gabrieldelgadoo/CV19_TETUAN/README.md

TODO LA INFO SE ENCUENTRA AQUI:

[https://cv19-tetuan.readthedocs.io/en/latest/#cv19_tetuan](https://cv19-tetuan.readthedocs.io/en/latest/#cv19_tetuan)

TODO LOS FICHEROS EN "ARCHIVOS STL"
