gabrieldelgadoo/CV19_TETUAN/docs/configs.md

## Configuraciones para Impresoras

### Prusa MKS3

Comprobado con Modelo A, GM

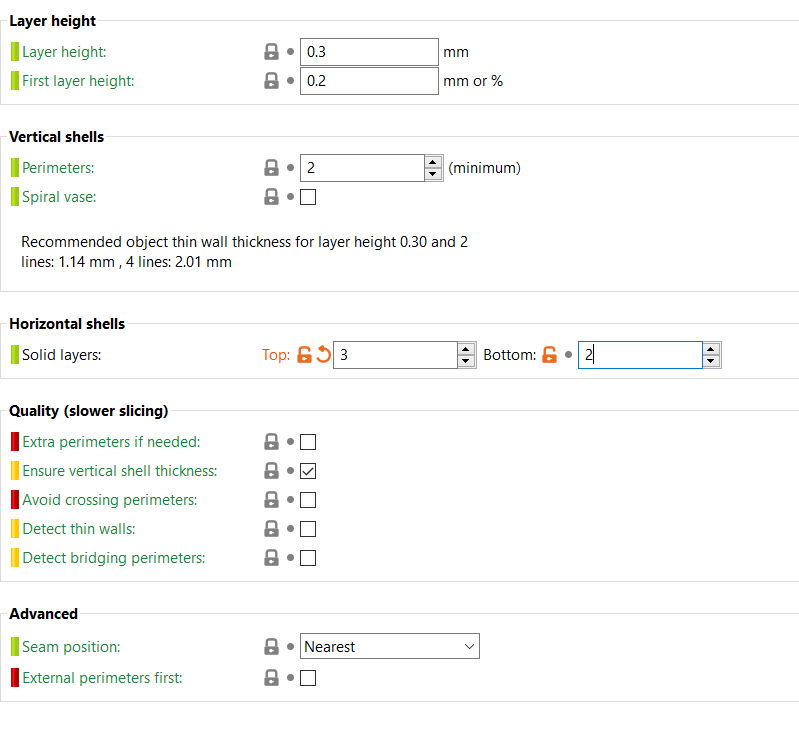
[picture p28: docs/configs/Prusa_MKS3/1.png]

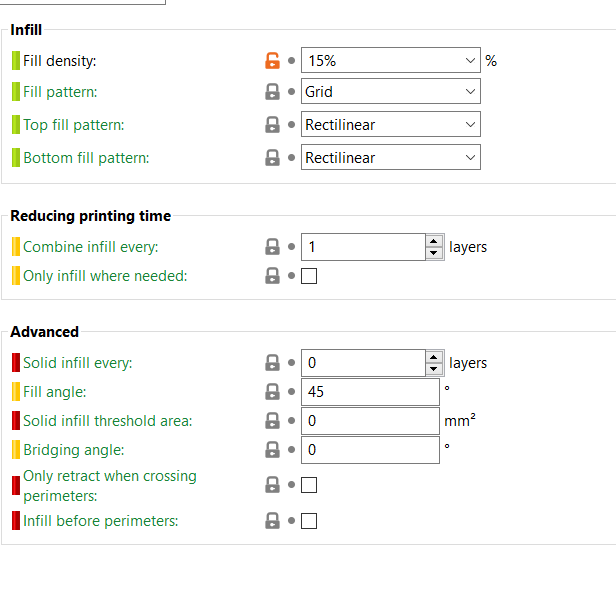
[picture p29: docs/configs/Prusa_MKS3/2.png]

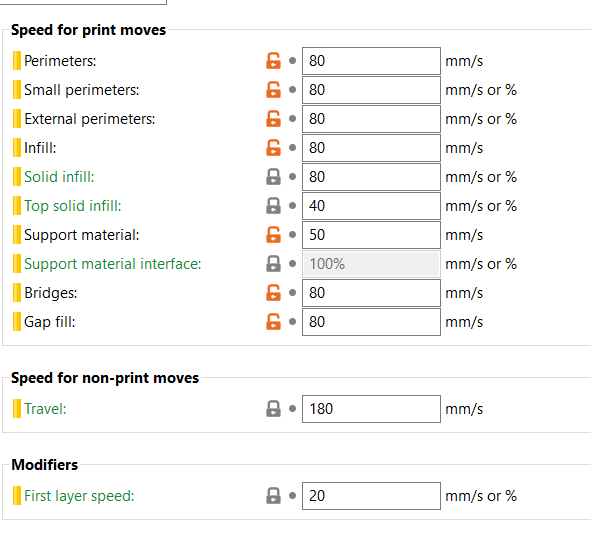
[picture p30: docs/configs/Prusa_MKS3/3.png]


### Ender 3

Comprobado con Modelo A

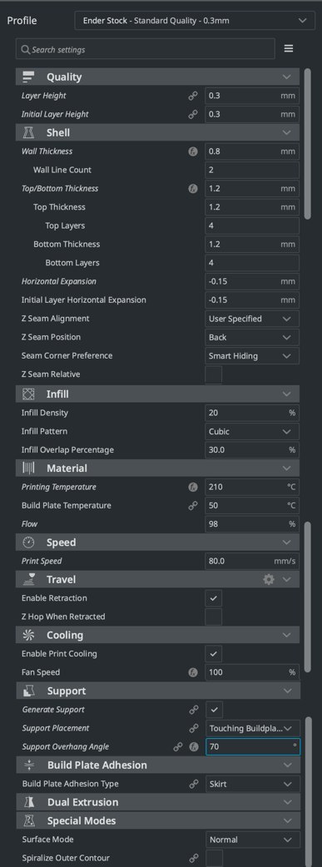
[picture p31: docs/configs/Ender3/1_Modelo_A.jpg]


[Cura Profile](configs/Ender3/Ender_Stock.curaprofile)

### Quiero anadir algo

Puedes hacer un Pull Request aqui: [https://github.com/gabrieldelgadoo/CV19_TETUAN](https://github.com/gabrieldelgadoo/CV19_TETUAN)

O escribir a mordondro[]gmail.com o @mordondro en telegram
