gabrieldelgadoo/CV19_TETUAN/docs/entrega.md

<p style="font-size: 2em;font-weight: bold;">
FAQ TETUAN</p>

## FAQ TETUAN

### Hay Version Homologada/acceptada?

Como sabéis hoy nos han comunicado que la visera ya no está validada por Sanidad de la Comunidad de Madrid, eso no quiere decir que no sirva.
Los Admins estan en ello de “Re-Validar” el diseno y esperamos que pronto sabemos mas.

### Donde conseguir PVC y Goma?

Tenemos en Tetuan mucho PVC gracias a el Grupo Social de la ONCE.
Para Pedidos dentro del Grupo no se "conseguir" comprar PVC, porque entregamos las Viseras sin montar.
Si quieres usar PVC para Viseras, que das tu a otra gente puedes preguntar en el Chat para poder circularlo hasta ti(por ejemplo con los Mensajeros)

### El grupo TG-Tetuan, para quien es?
En este grupo nos encontramos todos los Makers con Impresoras 3D para hacer Viseras!
O Gente que tiene el siguiente material y puede ayudar: Goma, Pantallas

Cualquier otra cosa teneis los otros canales de COVID, y si no encontráis ayudamos! 

### STOCK TETUAN

Encantando! Por Favor sigue estos 3 Pasos!

#### Como entrar en el Stock de Tetuan

1-Stock de Madrid por Barrio POR PERSONA: https://docs.google.com/forms/d/e/1FAIpQLSfA18D42zJwqL4fc2RPUaCodoov1gC751ZN3rm54v0EyADycg/viewform

Si ya habéis dado vuestros Impresiones a alguien, 091, bomberos, sanitarios, etc. Por Favor contabilizadlo aquí!

Por ejemplo:  Si tenías 15 viseras en stock pero las has entregado...Modificas el formulario de “Stock por Persona” para volver a tener 0.

#### Como cambio mi Stock?

- Entrar en tu Correo electrónico
- Buscar el mail de Google Forms
- Click “editar respuesta”
- Borrar tu Stock personal
- Enviar

No haceis una nueva submission del Formulario! Os ha llegado un mensaje al correo electronice de Googel Forms, donde hay un enlace para editar la respuesta!
A usar este!

### Que Modelo a imprimir?

MODELO ACEPTADO POR SANIDAD EN MADRID: https://covidmadrid.com/modelos-a-imprimir/
Existe también el Modelo del Gregorio Marañón pre-aprobado

### He impreso….que hago ahora?

Cuando tengáis el material listo y desinfectado (trapo con agua y un poquito de lejia)  ya sea montado, no montado, viseras homologadas, no homologadas, con PVCs, sin el, con goma, sin ella, da igual! Como si tenéis solo PVCs y gomas! Todo aporta! 
Si tienes un stock suficiente grande (10-15 Viseras) , por favor , en ese momento, COMUNICADLO a  @mordondro  y actualizad el Stock.

### Como entregar mis Viseras

1) Comprobar Calidad y dividir entre "para uso Sanitario", "NO para uso Sanitario"
 y "Basura"
2) Desinfectar las piezas con guantes y Lejilla/Alcool
3) Meterles en una bolsa limpia y desinfectada
4) Etiquetar la Bolsa con: ) Contenido ) para uso Sanitario o NO? )Nombre )RECIPIENTE

### Tenemos Punto de Recogida?

NO PODEMOS SALIR DE CASA PARA ENTREGAR COSAS! Si lo haces es por tu proprio asunto!
Tenemos contacto con el 091 y los Mensajeros y les recogen en casa de cada uno que tenga suficiente Stock! Cualquier pregunta: TG @mordondro

### Algun hospital me dice que necesitan!

Pedidos por nuestra Zona por favor a mi por Telegram o correo mordondro@gmail.com
(Sanitarios “privados”, Residencias de Ancianos, Supermercados, Tiendas, etc.)

### Quiero anadir algo

Puedes hacer un Pull Request aqui: [https://github.com/gabrieldelgadoo/CV19_TETUAN](https://github.com/gabrieldelgadoo/CV19_TETUAN)

O escribir a mordondro[]gmail.com o @mordondro en telegram
