gabrieldelgadoo/CV19_TETUAN/archivos STL/Madrid Modelo A/Modelo_A_V2_AdrianL_fijacion.stl

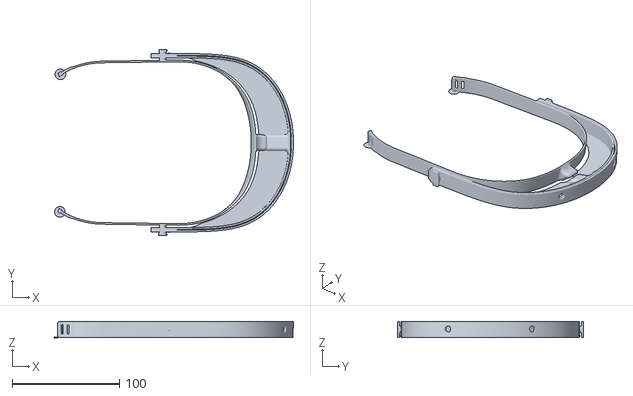
[picture p32: CAD file, 2020-04-06]
archivos STL/Madrid Modelo A/Modelo_A_V2_AdrianL_fijacion.stl
223.0 x 173.7 x 15.0
