gabrieldelgadoo/CV19_TETUAN/archivos STL/Madrid Modelo B/por partes/B2 Visera Madrid-Aprobada 1.0_fijacion.stl

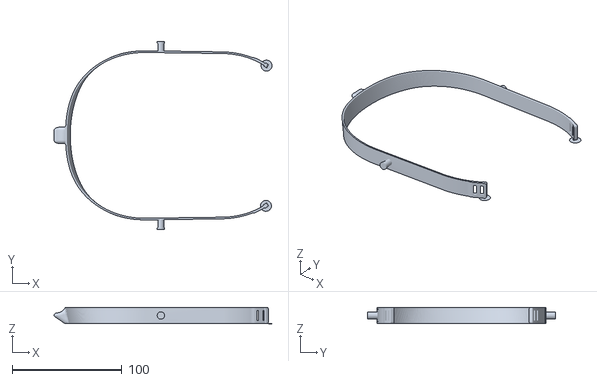
[picture p33: CAD file, 2020-04-17]
archivos STL/Madrid Modelo B/por partes/B2 Visera Madrid-Aprobada 1.0_fijacion.stl
198.7 x 171.2 x 15.0
