gabrieldelgadoo/CV19_TETUAN/archivos STL/Madrid Modelo B/Visera_B_junto_21x18_fijacion.stl

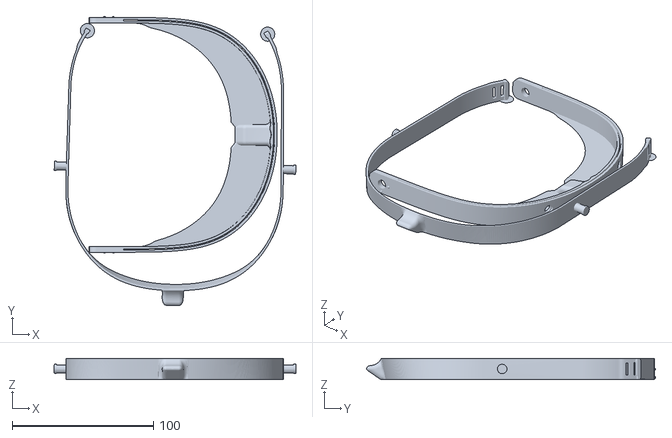
[picture p34: CAD file, 2020-04-22]
archivos STL/Madrid Modelo B/Visera_B_junto_21x18_fijacion.stl
171.2 x 204.8 x 15.0
