gabrieldelgadoo/CV19_TETUAN/archivos STL/Modelo A+B Accesorios/Adapter Modelo A 15mm.stl

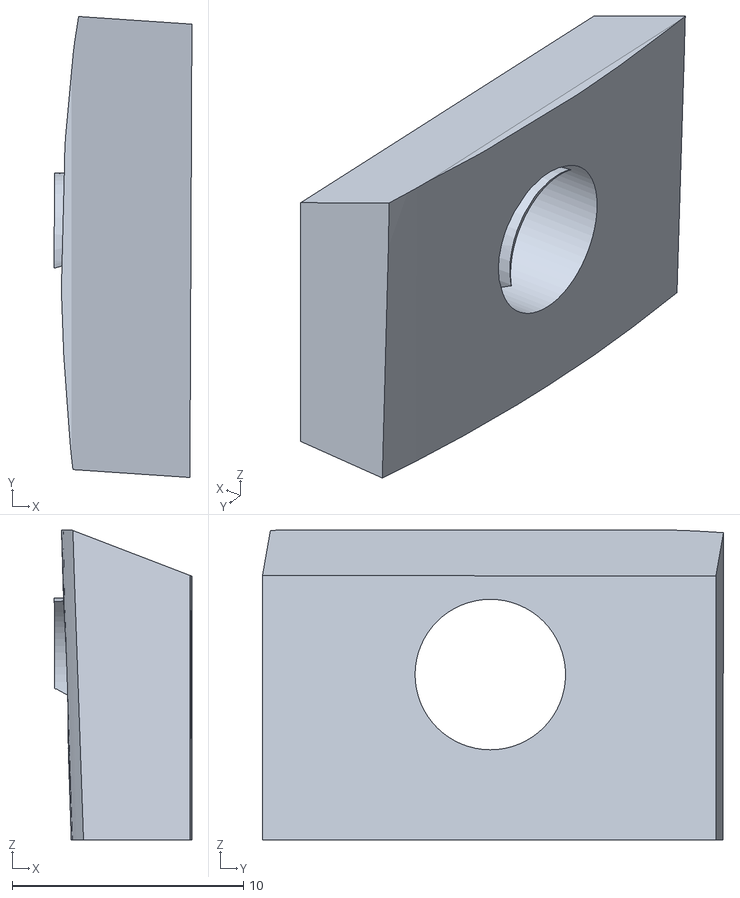
[picture p35: CAD file, 2020-04-04]
archivos STL/Modelo A+B Accesorios/Adapter Modelo A 15mm.stl
5.96 x 19.9 x 13.4
