gabrieldelgadoo/CV19_TETUAN/archivos STL/Modelos Gregorio Maranon/GM_v3_Tetuan.stl

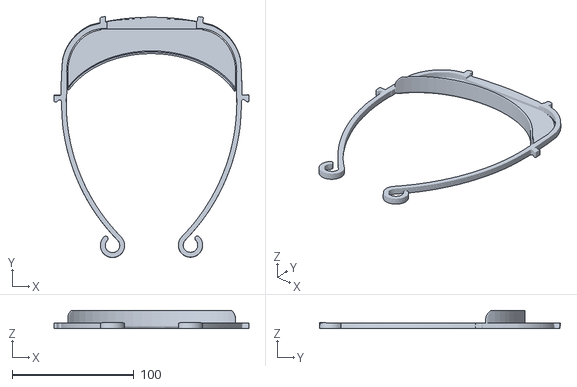
[picture p36: CAD file, 2020-04-17]
archivos STL/Modelos Gregorio Maranon/GM_v3_Tetuan.stl
159.9 x 197.8 x 15.0
