gabrieldelgadoo/CV19_TETUAN/archivos STL/visera_ultima_version(con ventilacion).stl

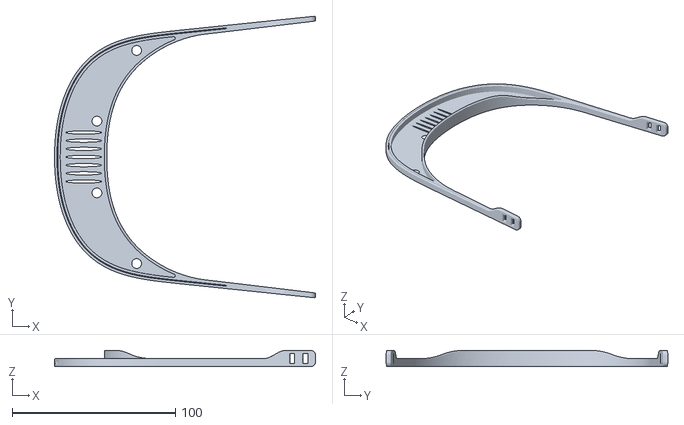
[picture p37: CAD file, 2020-04-04]
archivos STL/visera_ultima_version(con ventilacion).stl
159.8 x 172.4 x 10.0
