gabrieldelgadoo/CV19_TETUAN/archivos STL/Madrid Modelo B/Visera_B_junto_21x18.stl

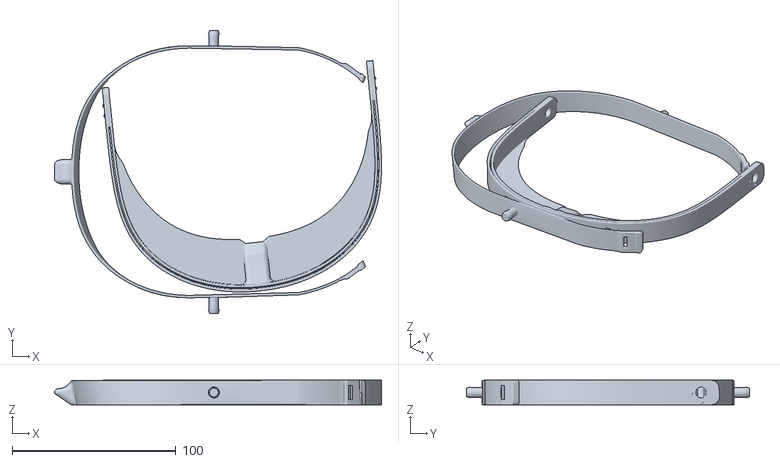
[picture p38: CAD file, 2020-04-04]
archivos STL/Madrid Modelo B/Visera_B_junto_21x18.stl
199.9 x 173.2 x 15.0
