gabrieldelgadoo/CV19_TETUAN/archivos STL/Modelo A+B Accesorios/punzonLH.stl

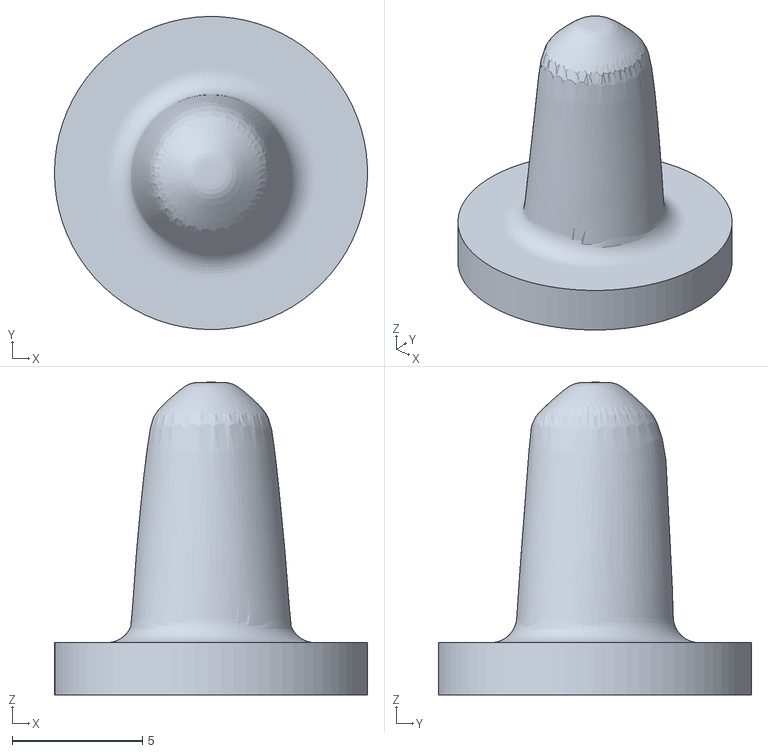
[picture p39: CAD file, 2020-04-04]
archivos STL/Modelo A+B Accesorios/punzonLH.stl
12.0 x 12.0 x 12.0
