gabrieldelgadoo/CV19_TETUAN/archivos STL/Modelos Gregorio Maranon/GM V3_Tetuan_2x_23x21.stl

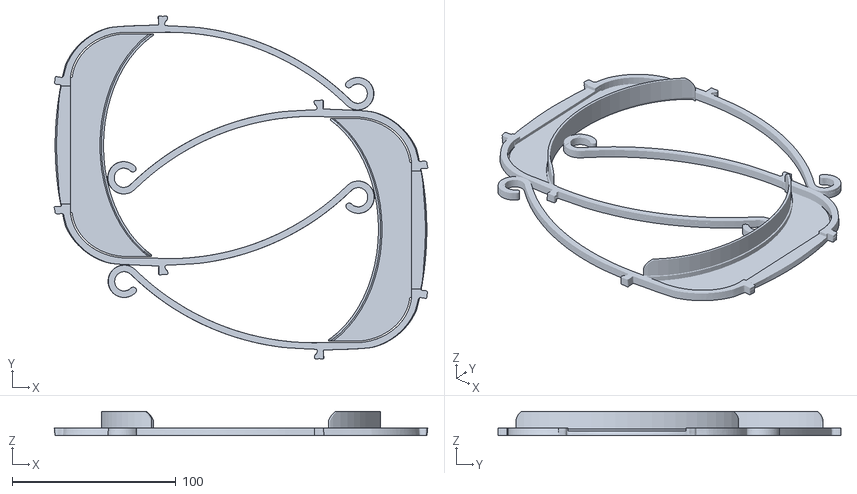
[picture p40: CAD file, 2020-04-07]
archivos STL/Modelos Gregorio Maranon/GM V3_Tetuan_2x_23x21.stl
228.6 x 209.8 x 14.8
