gabrieldelgadoo/CV19_TETUAN/archivos STL/Visor_Europeo_V21.stl

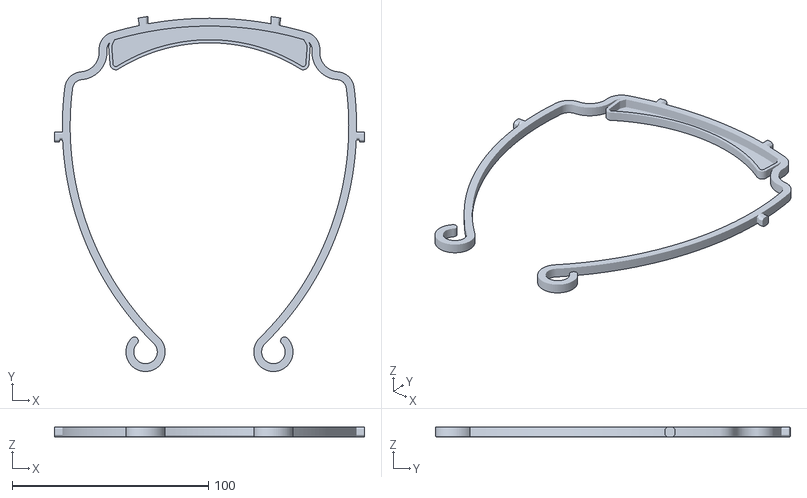
[picture p41: CAD file, 2020-04-04]
archivos STL/Visor_Europeo_V21.stl
158.0 x 181.0 x 5.00
