gabrieldelgadoo/CV19_TETUAN/archivos STL/Madrid Modelo B/Arandelas Visera Madrid-Aprobada 1.0.stl

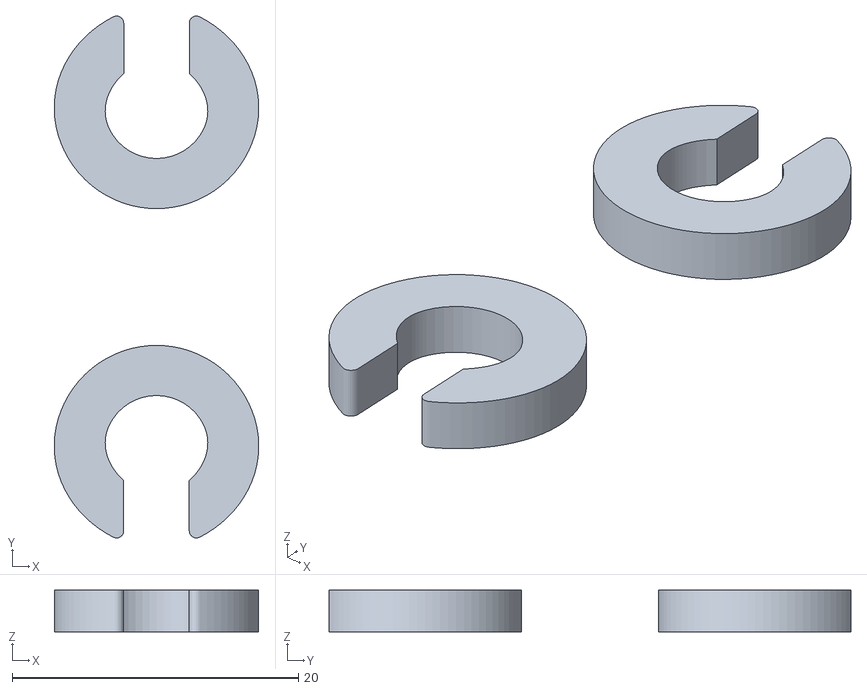
[picture p42: CAD file, 2020-04-04]
archivos STL/Madrid Modelo B/Arandelas Visera Madrid-Aprobada 1.0.stl
14.3 x 36.5 x 2.90
