gabrieldelgadoo/CV19_TETUAN/archivos STL/Madrid Modelo B/por partes/B1 Visera Madrid-Aprobada 1.0.stl

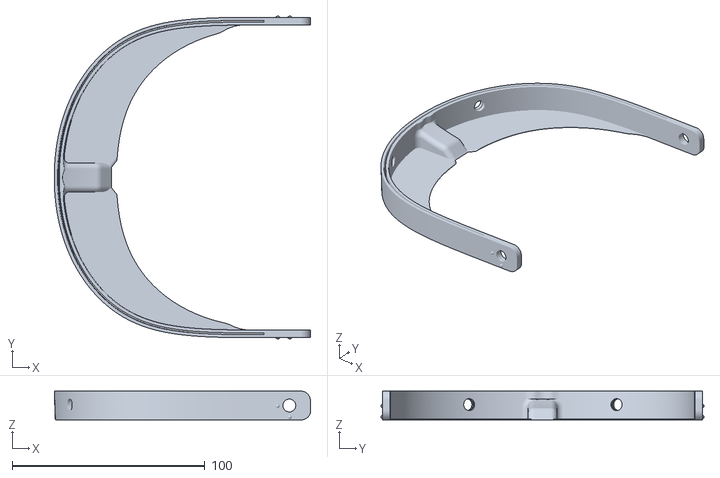
[picture p43: CAD file, 2020-04-04]
archivos STL/Madrid Modelo B/por partes/B1 Visera Madrid-Aprobada 1.0.stl
133.2 x 167.8 x 15.0
