gabrieldelgadoo/CV19_TETUAN/archivos STL/Modelos Gregorio Maranon/GM V3_Tetuan_2x_22x22.stl

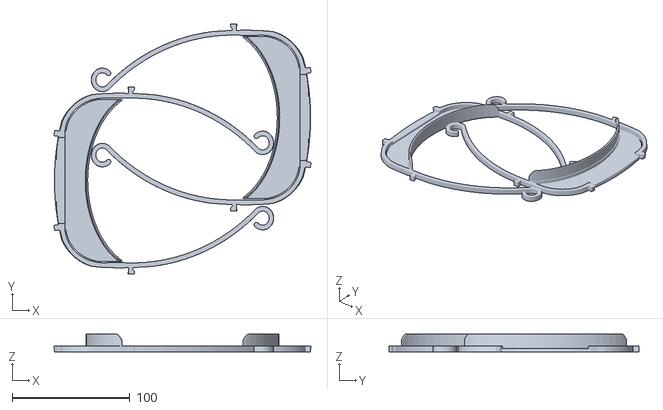
[picture p44: CAD file, 2020-04-07]
archivos STL/Modelos Gregorio Maranon/GM V3_Tetuan_2x_22x22.stl
218.2 x 212.5 x 15.0
