gabrieldelgadoo/CV19_TETUAN/archivos STL/Visera_Europea_V1.stl

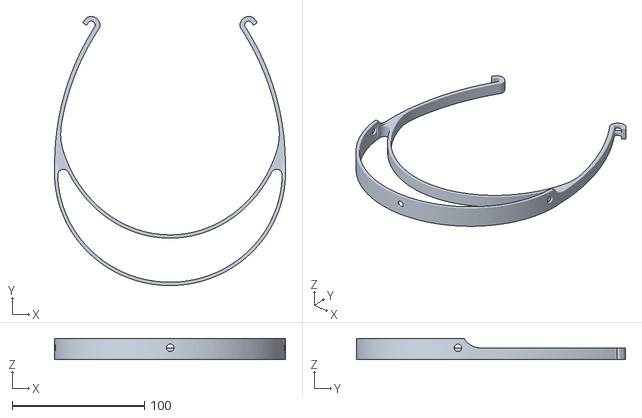
[picture p45: CAD file, 2020-04-04]
archivos STL/Visera_Europea_V1.stl
174.7 x 203.6 x 16.0
