gabrieldelgadoo/CV19_TETUAN/archivos STL/Madrid Modelo A/A -Principal Visera Madrid-Aprobada 1.0.stl

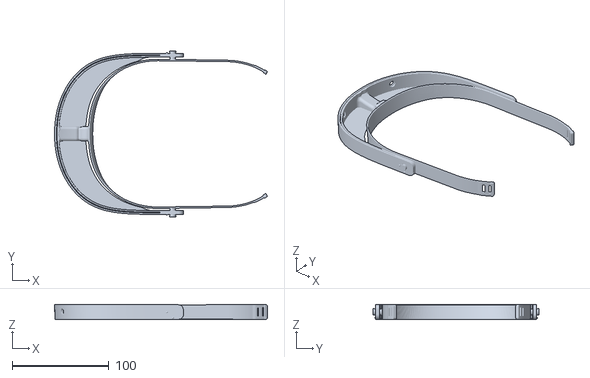
[picture p46: CAD file, 2020-04-04]
archivos STL/Madrid Modelo A/A -Principal Visera Madrid-Aprobada 1.0.stl
220.0 x 171.2 x 15.0
