gabrieldelgadoo/CV19_TETUAN/archivos STL/Modelos Gregorio Maranon/GM_V3.stl

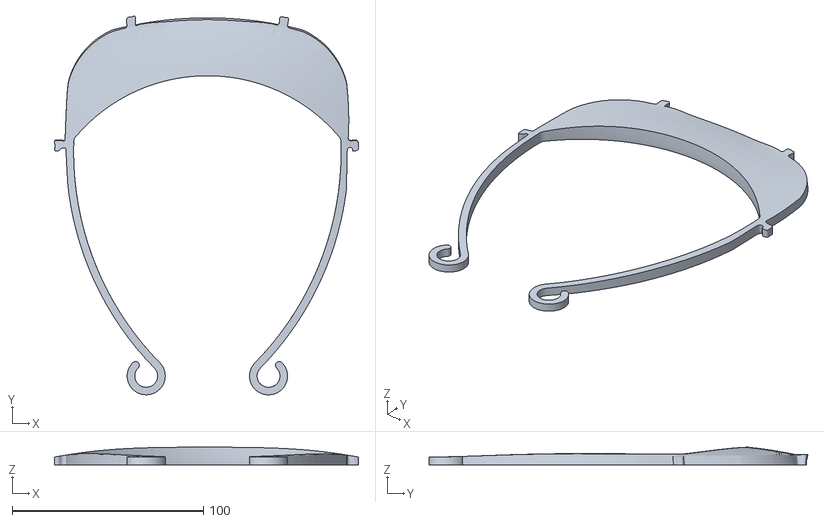
[picture p47: CAD file, 2020-04-04]
archivos STL/Modelos Gregorio Maranon/GM_V3.stl
159.1 x 198.2 x 9.26
