gabrieldelgadoo/CV19_TETUAN/(list of files, cad)

Other CAD files:
archivos STL/Madrid Modelo A/Modelo_A_V2_AdrianLS.stl
archivos STL/Madrid Modelo B/por partes/B2 Visera Madrid-Aprobada 1.0.stl
archivos STL/Madrid Modelo A/A -Principal Visera Madrid-Aprobada 1.0_fijacion.stl
archivos STL/Visera_hibrida.stl
archivos STL/Modelos Gregorio Maranon/GM V2.stl
